kacperugorny1/Weather-Station/Core/Src/main.c

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
/* Includes ------------------------------------------------------------------*/
#include "main.h"

/* USER CODE BEGIN Includes */

#include <stdio.h>
#include <string.h>
#include <stdbool.h>
#include "bmp280.h"
#include <math.h>
/* USER CODE END Includes */

/* USER CODE BEGIN PD */

#define code "8Tar"
/* USER CODE END PD */

I2C_HandleTypeDef hi2c1;

IWDG_HandleTypeDef hiwdg;

RTC_HandleTypeDef hrtc;

UART_HandleTypeDef huart1;
UART_HandleTypeDef huart2;

void SystemClock_Config(void);
static void MX_GPIO_Init(void);
static void MX_RTC_Init(void);
static void MX_USART2_UART_Init(void);
static void MX_I2C1_Init(void);
static void MX_USART1_UART_Init(void);
static void MX_IWDG_Init(void);
/* USER CODE BEGIN 0 */
//SIM800l
uint8_t Rx_bit;
char Rx_placeholder[10];
char Rx_data[100] = "";
char Locs[50] = "";
char Num[50] = "";
int pos = 0;
int msg = 0;
uint32_t tm = 0;
bool completed = false;
bool read = false;

//BMP

BMP280_HandleTypedef bmp280;

float altitude ,pressure, p, temperature, humidity;
//AHT20
float temp;
float humi;
//commands
char Tx_data[15][200] = {"AT\r",
    "AT+SAPBR=3,1,Contype,\"GPRS\"\r",
    "AT+SAPBR=3,1,APN,\"internet\"\r",
    "AT+SAPBR=1,1\r",
    "AT+CLBS=1,1\r",
    "AT+CNUM\r",
    "AT+HTTPINIT\r",
    "AT+HTTPPARA=CID,\"1\"\r",
    "AT+HTTPSSL=0\r",
    "AT+HTTPPARA=URL,\"http://185.201.114.232:5000/NewData?num=123456789\"\r",
    "AT+HTTPACTION=1\r",
    "AT+HTTPTERM\r",
    "AT+SAPBR=0,1\r"
};
int __io_putchar(int ch)
{
  if (ch == '\n') {
    uint8_t ch2 = '\r';
    HAL_UART_Transmit(&huart2, &ch2, 1, HAL_MAX_DELAY);
  }
  HAL_UART_Transmit(&huart2, (uint8_t*)&ch, 1, HAL_MAX_DELAY);
  return 1;
}

void HAL_UART_RxCpltCallback(UART_HandleTypeDef *huart)
{
  //Sim800l repeats the command of the user so this line skips it
  if(read == false && Rx_bit == '\n') read = true;
  else if(read == true){
    Rx_data[pos++] = Rx_bit;
    if(Rx_bit == '\n'){
      HAL_UART_Transmit(&huart2, (uint8_t *)Rx_data, pos, 1000);
      //Read latitude and longitude
      if(msg == 4 && Rx_data[0] == '+'){
	HAL_UART_Receive(&huart1, (uint8_t*)Rx_placeholder, 6, 1000);
	printf("Komunikacja udana - LOCS: \n");
	strcpy(Locs,Rx_data);
	pos = 0;
      }
      //read number
      else if(msg == 5 && Rx_data[0] == '+'){
	HAL_UART_Receive(&huart1, (uint8_t*)Rx_placeholder, 6, 1000);
	printf("Komunikacja udana - tel_num\n");
	strcpy(Num,Rx_data);
	pos = 0;
      }
      //This line makes program wait for http response
      if(msg == 10 && ((Rx_data[0] == 'O' && Rx_data[1] == 'K') || Rx_data[0] == '\r')) {
	  pos = 0;
      }
      //Here it writes next functions, and sets the post url
      else{
	printf("Komunikacja udana %d: \n",msg);
	pos = 0; read = false; msg++;
	if(msg == 9){
	  float latitude = 0.0, longitude = 0.0;
	  char *numberStart = strstr(Num,"\"+");
	  char *numberEnd = strstr(numberStart + 2,"\"");
	  size_t len = numberEnd - numberStart;
	  char num[len + 1];
	  strncpy(num, numberStart, len);
	  num[len] = '\0';
	  strcpy(num, &num[4]);
	  sscanf(Locs, "+CLBS: 0,%f,%f,", &longitude, &latitude);
	  sprintf(Tx_data[msg], "AT+HTTPPARA=URL,\"http://185.201.114.232:5000/NewData?num=%s&latitude=%.6f&longitude=%.6f&temp=%.2f&humi=%.2f&press=%.2f&code=%s\"\r",num,latitude,longitude,temp-2,humi,pressure,code);
	}
	if(msg < 13)
	HAL_UART_Transmit_IT(&huart1, (uint8_t *)Tx_data[msg], strlen(Tx_data[msg]));
	else completed = true;

      }
    }
  }
  //keep receving data
  HAL_UART_Receive_IT(&huart1, &Rx_bit, 1);
  HAL_IWDG_Refresh(&hiwdg);

}

void HAL_UART_TxCpltCallback(UART_HandleTypeDef *huart)
{

}

/* USER CODE END 0 */

/**
  * @brief  The application entry point.
  * @retval int
  */
int main(void)
{

  /* MCU Configuration--------------------------------------------------------*/

  /* Reset of all peripherals, Initializes the Flash interface and the Systick. */
  HAL_Init();

  /* Configure the system clock */
  SystemClock_Config();

  /* Initialize all configured peripherals */
  MX_GPIO_Init();
  MX_RTC_Init();
  MX_USART2_UART_Init();
  MX_I2C1_Init();
  MX_USART1_UART_Init();
  MX_IWDG_Init();
  /* USER CODE BEGIN 2 */

  const uint16_t addr = 0b0111000; //0x38
  const int addr_wr = addr<<1;
  const int addr_rc = addr_wr + 1;
  uint32_t temp_data;
  uint8_t init[3] = {0xbe, 0x08, 0x00};
  uint8_t measure[3] = {0xac, 0x33, 0x00};
  uint8_t data[6];
  uint32_t time_stamp = HAL_GetTick();
  HAL_IWDG_Refresh(&hiwdg);
  HAL_I2C_Master_Receive(&hi2c1, addr_rc, (uint8_t *)data, 6, 1000);
  if((data[0] >> 3 & 1) != 1){
    printf("Kalibracja\n");
    HAL_I2C_Master_Transmit(&hi2c1, addr_wr, (uint8_t *)init, 3, 1000);
  }
  time_stamp = HAL_GetTick();
  while(HAL_GetTick() - time_stamp < 10) ;
  HAL_I2C_Master_Transmit(&hi2c1, addr_wr, (uint8_t *)measure, 3, 1000);
  time_stamp = HAL_GetTick();
  while(HAL_GetTick() - time_stamp < 85) ;
  HAL_I2C_Master_Receive(&hi2c1, addr_rc, (uint8_t *)data, 6, 1000);
  //AHT20 COMM FINISHED
  HAL_IWDG_Refresh(&hiwdg);
  //check control byte and calculate values
  if(((data[0] >> 7) & 1) == 0) {
    printf("Komunikacja udana \n");
    temp_data = ((uint32_t)data[3] << 16) + ((uint32_t)data[4] << 8) + (uint32_t)data[5];
    temp_data = temp_data & (~(0xFFF00000));
    temp = ((float)temp_data/1048576) * 200 - 50;
    temp_data = ((uint32_t)data[1] << 16) + ((uint32_t)data[2] << 8) + (uint32_t)data[3];
    temp_data = temp_data >> 4;
    humi = ((float)temp_data/1048576) * 100;
  }
  else
  {
    printf("Komunikacja nie udana\n");
  }
  printf("Temperatura wynosi %f *C\n", temp);
  printf("Wilgotnosc  wynosi %f %%\n", humi);
  HAL_IWDG_Refresh(&hiwdg);



  bmp280_init_default_params(&bmp280.params);
  bmp280.addr = BMP280_I2C_ADDRESS_1;
  bmp280.i2c = &hi2c1;
  while (!(bmp280_init(&bmp280, &bmp280.params)))
  {
	time_stamp = HAL_GetTick();
	while(HAL_GetTick() - time_stamp < 2000) ;
  }

  HAL_IWDG_Refresh(&hiwdg);
  bool bme280p = bmp280.id == BMP280_CHIP_ID;
  time_stamp = HAL_GetTick();
  while(HAL_GetTick() - time_stamp < 100) ;
  while (!bmp280_read_float(&bmp280, &temperature, &pressure, &humidity)) {
	  time_stamp = HAL_GetTick();
	  while(HAL_GetTick() - time_stamp < 2000) ;
  }

  HAL_IWDG_Refresh(&hiwdg);
  p = pressure/100;
  altitude = 44330.0*(1-pow(p/1013.25, 1/5.255));

  time_stamp = HAL_GetTick();
  while(HAL_GetTick() - time_stamp < 500) ;

  HAL_IWDG_Refresh(&hiwdg);

  HAL_UART_Receive_IT(&huart1, &Rx_bit, 1);
  HAL_UART_Transmit_IT(&huart1, (uint8_t *)Tx_data[msg], strlen(Tx_data[msg]));
  HAL_GPIO_WritePin(LED_GPIO_Port, LED_Pin, GPIO_PIN_SET);
  while(!completed);

  printf("Going to sleep\n");
  HAL_PWR_EnterSTANDBYMode();
  /* USER CODE END 2 */

  /* Infinite loop */
  /* USER CODE BEGIN WHILE */
  while (1)
  {
    /* USER CODE END WHILE */

    /* USER CODE BEGIN 3 */
  }
  /* USER CODE END 3 */
}

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
