kacperugorny1/Weather-Station/Project-Interval.ioc

Mcu.UserName=STM32L476RGTx
PA10.Signal=USART1_RX
PA2.Signal=USART2_TX
PA3.Signal=USART2_RX
PA5.GPIO_Label=LED
PA5.Signal=GPIO_Output
PA9.Signal=USART1_TX
PB8.Signal=I2C1_SCL
PB9.Signal=I2C1_SDA
